i3detroit/MQTT-Thermostat/rev.1/firmware/README.md

# i3Detroit MQTT Thermostat

This is based around a d1 mini, and is designed to work with homassistant.

Can control heating and cooling, or just heating

Does not have a hold button, to prevent users from trying to heat a sieve.

## Setup
* pio
* copy local.mk.example to local.mk and edit for your wifi network
* `make flash` to progarm
