i3detroit/MQTT-Thermostat/(threads)

Thread 5 (2020-08-29):

for next rev more robust output drivers

abzman, 2020-08-29:
use proper logic families and output drivers for switching section and LED drivers

abzman, 2020-08-31:
I can cut down on chips if we agree to swap the polarity of the enable signal.  the whole select/enable circuit can be done in a single cd4000, but I'm having trouble finding them

abzman, 2020-08-31:
if we flip the output polarity (which can be done in conjunction with #3 for no functional change) then it can all be done with a 4011 or 4093 which I can source

Thread 6 (2020-08-29):

for next rev use proper LED footprints

abzman, 2020-08-29:
pick LEDs to use, including right angle ones, and use the correct footprint so the LEDs don't extend past the edge of the board (fit in the case)

Thread 8 (2020-08-29):

i3 logo

abzman, 2020-08-29:
current i3 logo is wrong, use updated logo and code

Closed 2020-08-30.

Thread 9 (2020-08-29):

eeprom reading and writing

abzman, 2020-08-29:
current method is clunky and broken, use new method retrieving data structure from memory all at once

Thread 11 (2020-08-31):

for next rev solder jumpers to select address on IO expander

abzman, 2020-08-31:
either 0603 0 ohm resistors or solder jumper pads.  Could even do a default setting with a thin trace in between pads to make it cuttable to change the address.  I realize that this isn't possible with the screen unless we move off of the daughter board, but that can be set before soldering it down.

Thread 12 (2020-08-31):

for next rev allow powering from 24vac (or 12vdc)

abzman, 2020-08-31:
Either another module or just a switcher onboard.  Make sure that if the USB is populated or you are programming it the usb's 5v either doesn't power up the whole board or if it does then the board is low power enough to be ok being powered by usb (right now relays flipping on power on cause issues unless the board is unplugged)
