i3detroit/MQTT-Thermostat/rev.2-heat/esp23 i3 heat thermostat/esp23 i3 heat thermostat.kicad_pcb

## KiCad design rev.2-heat/esp23 i3 heat thermostat/esp23 i3 heat thermostat.kicad_pcb (2022-03-13)

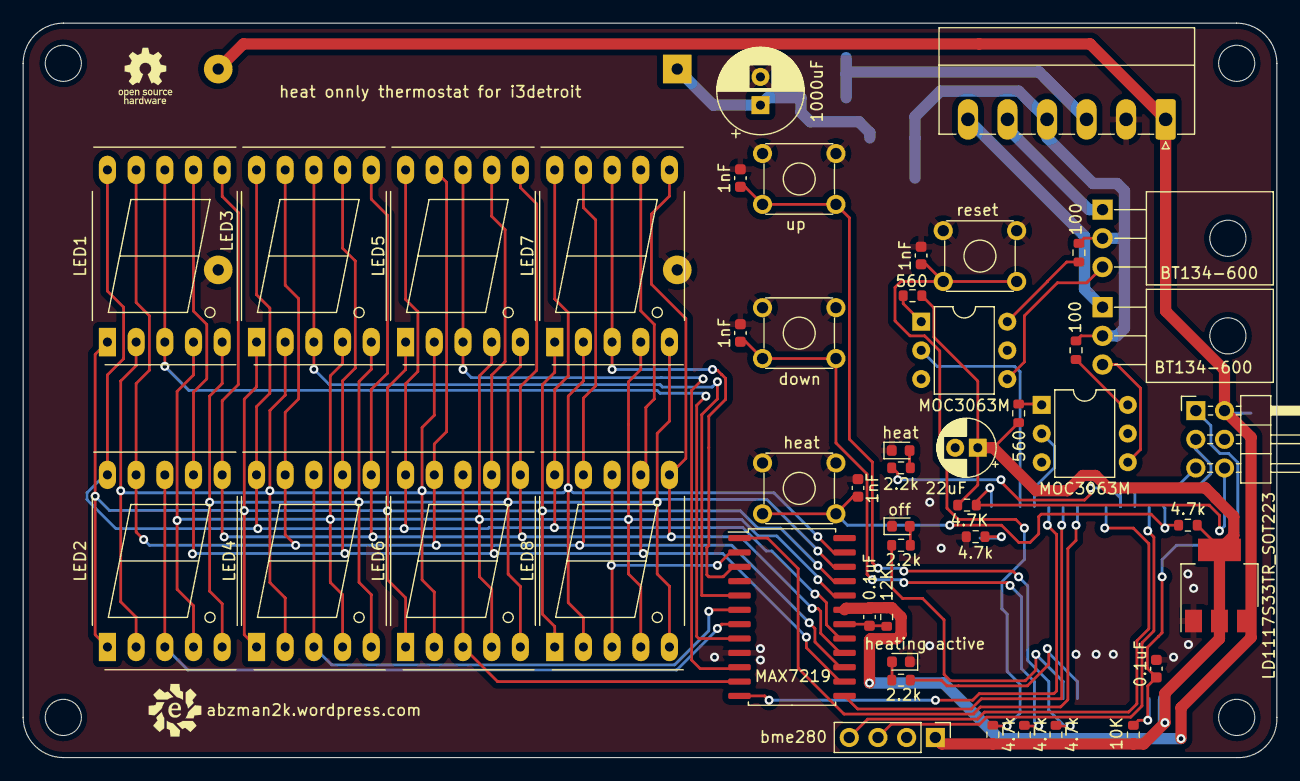
[picture p1: board esp23 i3 heat thermostat.kicad_pcb from above]

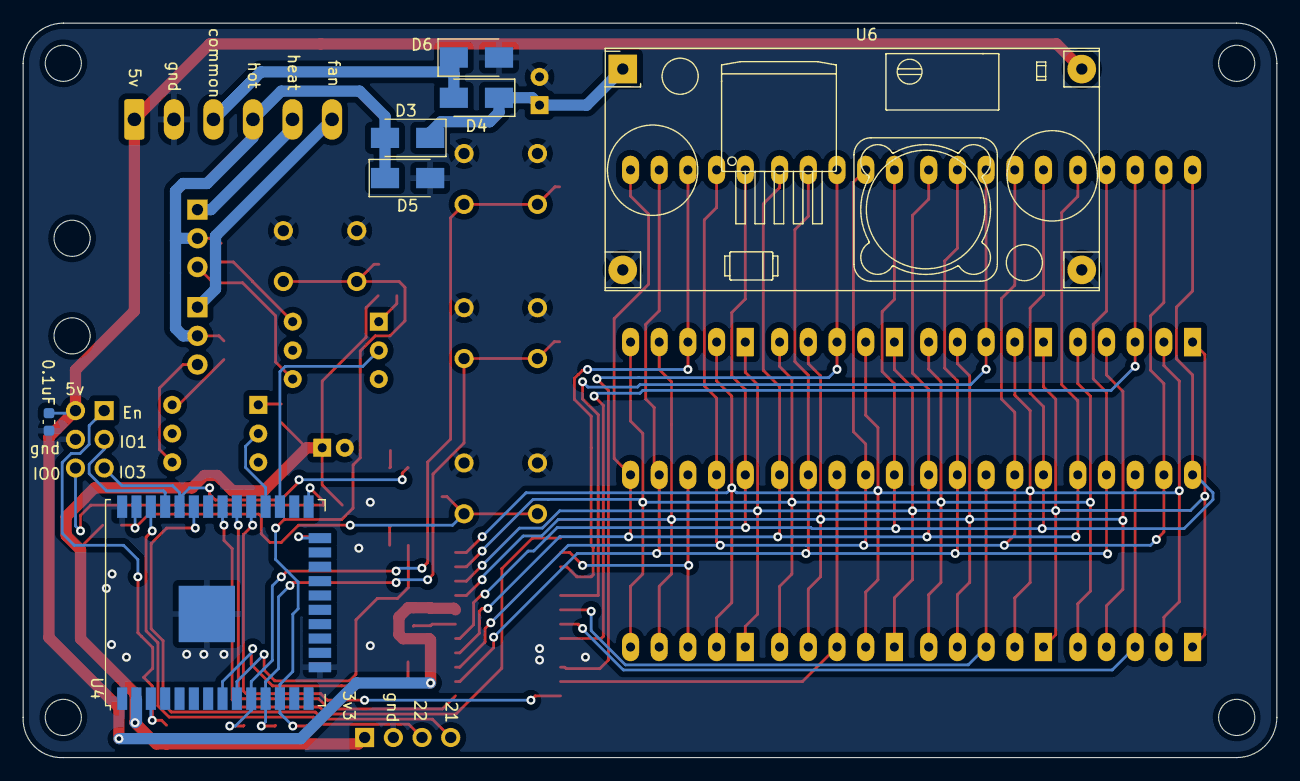
[picture p2: board esp23 i3 heat thermostat.kicad_pcb from below]

Board: 2 copper layers, 111.0 x 65.0 mm, 54 parts (7 on the bottom side), 52 nets.

Parts:
C1, C3, C7: 0.1uF; C_0603_1608Metric
C5: 1000uF; CP_Radial_D7.5mm_P2.50mm
C6: 22uF; CP_Radial_D5.0mm_P2.00mm
C8, C9, C10, C11: 1nF; C_0603_1608Metric
D3, D4, D5, D6: 1N4004; D_SMA
D8, D9, D10: LED; LED_0603_1608Metric
J1: Conn_01x06; PhoenixContact_MC_1,5_6-G-3.5_1x06_P3.50mm_Horizontal
J2: bme280; PinHeader_1x04_P2.54mm_Vertical
J4: Conn_02x03_Odd_Even; PinHeader_2x03_P2.54mm_Horizontal
LED1, LED2, LED3, LED4, LED5, LED6, LED7, LED8: LTS-6980HR; 7SegmentLED_LTS6760_LTS6780
Q1, Q2: BT134-600; TO-126-3_Horizontal_TabDown
R1: 12K; R_0603_1608Metric
R4, R5: 560; R_0603_1608Metric
R6, R7: 100; R_0603_1608Metric
R8, R15, R16, R17, R18: 4.7k; R_0603_1608Metric
R9: 10K; R_0603_1608Metric
R14: 4.7K; R_0603_1608Metric
R19, R20, R21: 2.2k; R_0603_1608Metric
SW2, SW3, SW4, SW5: SW_MEC_5E; SW_TH_Tactile_Omron_B3F-10xx
U1: MAX7219; SOP-24_7.5x15.4mm_P1.27mm
U2, U3: MOC3063M; DIP-6_W7.62mm
U4: ESP32-WROOM-32U
U5: LD1117S33TR_SOT223; SOT-223-3_TabPin2
U6: YAAJ_DCDC_StepDown_LM2596

Connections:
+3V3: C6.1, J2.1, R4.1, R5.1, R9.1, R14.1, R15.1, R16.1, R17.1, R18.1, U4.2 (VDD), U5.2 (VO)
+5V: C1.1, C7.1, J1.1, J4.2, R1.1, U1.19 (V+), U5.3 (VI), U6.4 (Vout)
+24V: C5.1, D3.1 (K), D4.1 (K), U6.1 (Vin)
/A: LED1.7 (a), LED2.7 (a), LED3.7 (a), LED4.7 (a), LED5.7 (a), LED6.7 (a), LED7.7 (a), LED8.7 (a), U1.14 (SEG_A)
/B: LED1.6 (b), LED2.6 (b), LED3.6 (b), LED4.6 (b), LED5.6 (b), LED6.6 (b), LED7.6 (b), LED8.6 (b), U1.16 (SEG_B)
/C: LED1.4 (c), LED2.4 (c), LED3.4 (c), LED4.4 (c), LED5.4 (c), LED6.4 (c), LED7.4 (c), LED8.4 (c), U1.20 (SEG_C)
/D: LED1.2 (d), LED2.2 (d), LED3.2 (d), LED4.2 (d), LED5.2 (d), LED6.2 (d), LED7.2 (d), LED8.2 (d), U1.23 (SEG_D)
/D1: LED8.3 (C.K.), LED8.8 (C.K.), U1.2 (DIG_0)
/D2: LED6.3 (C.K.), LED6.8 (C.K.), U1.11 (DIG_1)
/D3: LED4.3 (C.K.), LED4.8 (C.K.), U1.6 (DIG_2)
/D4: LED2.3 (C.K.), LED2.8 (C.K.), U1.7 (DIG_3)
/D5: LED7.3 (C.K.), LED7.8 (C.K.), U1.3 (DIG_4)
/D6: LED5.3 (C.K.), LED5.8 (C.K.), U1.10 (DIG_5)
/D7: LED3.3 (C.K.), LED3.8 (C.K.), U1.5 (DIG_6)
/D8: LED1.3 (C.K.), LED1.8 (C.K.), U1.8 (DIG_7)
/DP: LED1.5 (DP), LED2.5 (DP), LED3.5 (DP), LED4.5 (DP), LED5.5 (DP), LED6.5 (DP), LED7.5 (DP), LED8.5 (DP), U1.22 (SEG_DP)
/E: LED1.1 (e), LED2.1 (e), LED3.1 (e), LED4.1 (e), LED5.1 (e), LED6.1 (e), LED7.1 (e), LED8.1 (e), U1.21 (SEG_E)
/ESP_EN: C3.1, J4.1, R9.2, U4.3 (EN)
/ESP_IO0: J4.6, R14.2, U4.25 (IO0)
/ESP_IO1: J4.3, U4.35 (TXD0/IO1)
/ESP_IO2: R8.1, U4.24 (IO2)
/ESP_IO3: J4.5, R20.1, U4.34 (RXD0/IO3)
/ESP_IO5: U1.12 (LOAD), U4.29 (IO5)
/ESP_IO16: U2.2, U4.27 (IO16)
/ESP_IO17: U3.2, U4.28 (IO17)
/ESP_IO18: U1.13 (CLK), U4.30 (IO18)
/ESP_IO19: U1.1 (DIN), U4.31 (IO19)
/ESP_IO21: J2.4, U4.33 (IO21)
/ESP_IO22: J2.3, U4.36 (IO22)
/ESP_IO23: C11.2, R18.2, SW5.3 (K), SW5.4 (A), U4.37 (IO23)
/ESP_IO25: C10.2, R17.2, SW4.3 (K), SW4.4 (A), U4.10 (IO25)
/ESP_IO26: C9.2, R16.2, SW3.3 (K), SW3.4 (A), U4.11 (IO26)
/ESP_IO27: C8.2, R15.2, SW2.3 (K), SW2.4 (A), U4.12 (IO27)
/ESP_IO32: R19.1, U4.8 (IO32)
/ESP_IO33: R21.1, U4.9 (IO33)
/F: LED1.9 (f), LED2.9 (f), LED3.9 (f), LED4.9 (f), LED5.9 (f), LED6.9 (f), LED7.9 (f), LED8.9 (f), U1.15 (SEG_F)
/Fan: J1.6, Q2.1 (A1)
/G: LED1.10 (g), LED2.10 (g), LED3.10 (g), LED4.10 (g), LED5.10 (g), LED6.10 (g), LED7.10 (g), LED8.10 (g), U1.17 (SEG_G)
/Heat: J1.5, Q1.1 (A1)
/Hot: D3.2 (A), D5.1 (K), J1.4, Q1.2 (A2), Q2.2 (A2), R6.2, R7.2
/common: D4.2 (A), D6.1 (K), J1.3
GND: C3.2, C5.2, C6.2, C7.2, C8.1, C9.1, C10.1, C11.1, D5.2 (A), D6.2 (A), D8.1 (K), D9.1 (K), D10.1 (K), J1.2, J2.2, J4.4, R8.2, SW2.1, SW2.2, SW3.1, SW3.2, SW4.1, SW4.2, SW5.1, SW5.2, U1.4 (GND), U1.9 (GND), U4.1 (GND), U4.15 (GND), U4.38 (GND), U4.39 (GND), U5.1 (GND), U6.2 (GND), U6.3 (GND)
unnamed: C1.2, R1.2, U1.18 (ISET)
unnamed: D8.2 (A), R19.2
unnamed: D9.2 (A), R20.2
unnamed: D10.2 (A), R21.2
unnamed: Q1.3 (G), U2.4
unnamed: Q2.3 (G), U3.4
unnamed: R4.2, U2.1
unnamed: R5.2, U3.1
unnamed: R6.1, U2.6
unnamed: R7.1, U3.6
