i3detroit/MQTT-Thermostat/rev.1/board/thermostat.kicad_pcb

## KiCad design rev.1/board/thermostat.kicad_pcb (2022-02-15)

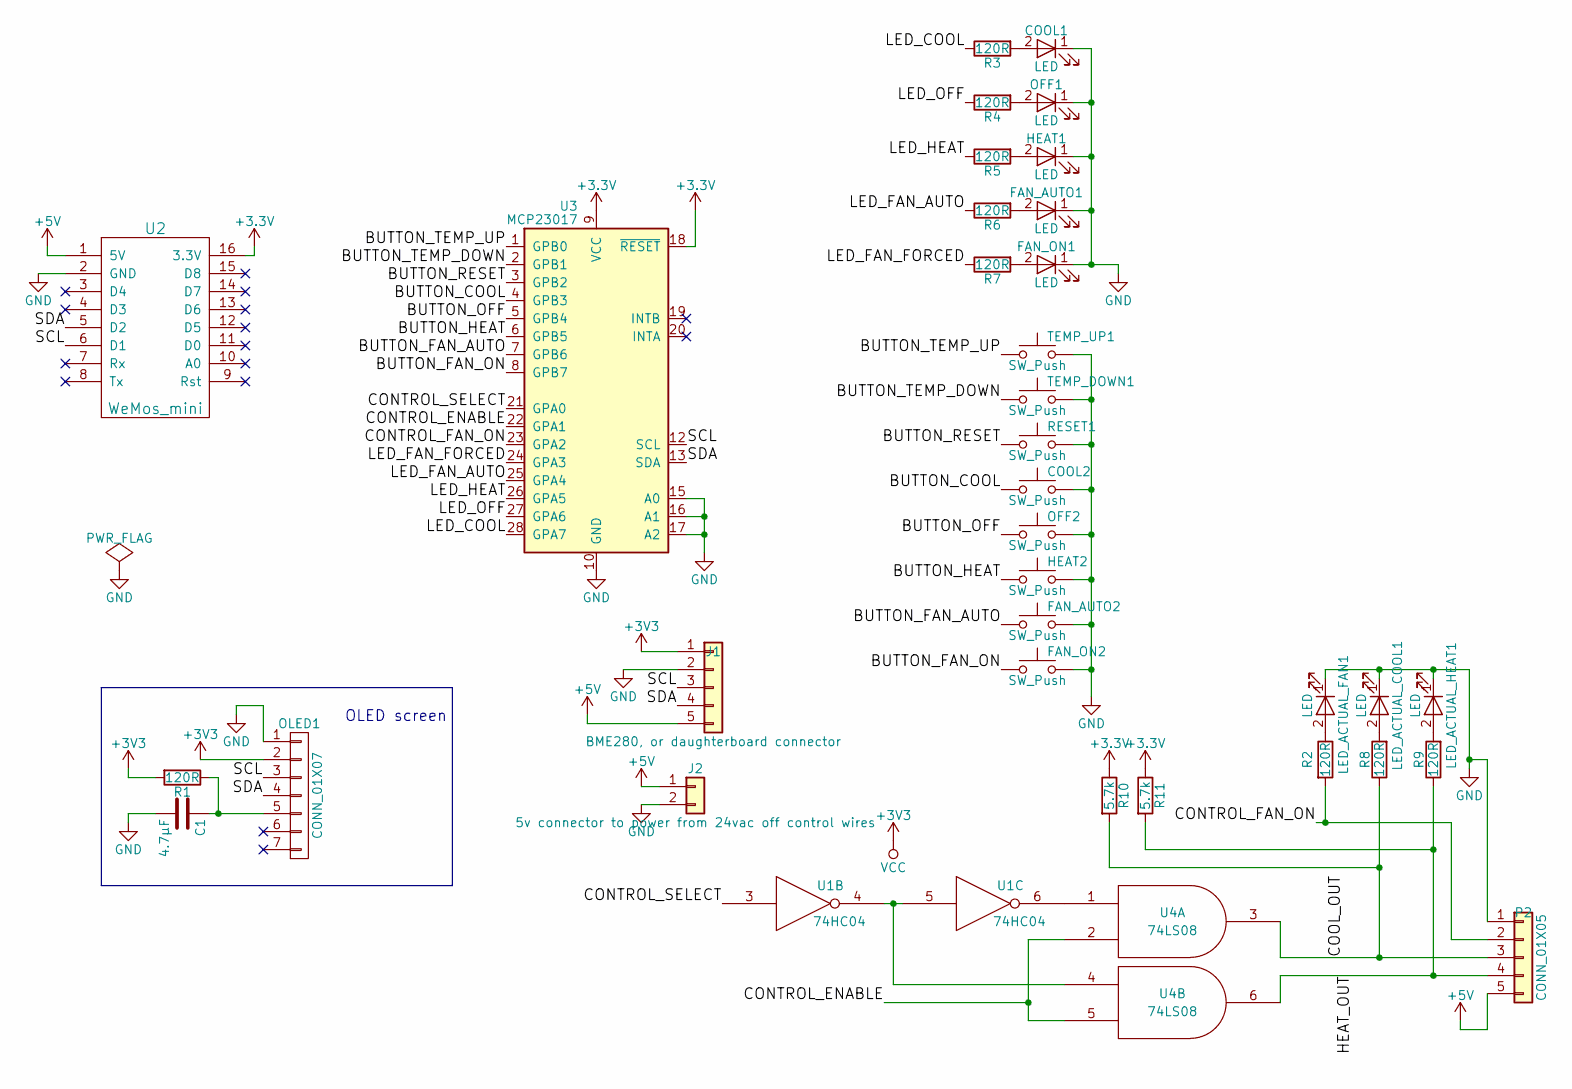
[picture p3: schematic thermostat.kicad_sch]

Parts:
C1: 4.7µF; C_0603_HandSoldering
COOL1: LED; LED_D3.0mm
COOL2: SW_Push; SW_Tactile_SPST_Angled
FAN_AUTO1: LED; LED_D3.0mm
FAN_AUTO2: SW_Push; SW_PUSH_6mm
FAN_ON1: LED; LED_D3.0mm
FAN_ON2: SW_Push; SW_PUSH_6mm
HEAT1: LED; LED_D3.0mm
HEAT2: SW_Push; SW_Tactile_SPST_Angled
J1: BME280, or daughterboard connector; Pin_Header_Straight_1x05
J2: 5v connector to power from 24vac off control wires; Pin_Header_Straight_1x02
LED_ACTUAL_COOL1: LED; LED_D3.0mm
LED_ACTUAL_FAN1: LED; LED_D3.0mm
LED_ACTUAL_HEAT1: LED; LED_D3.0mm
OFF1: LED; LED_D3.0mm
OFF2: SW_Push; SW_Tactile_SPST_Angled
OLED1: CONN_01X07; OLED_I2C_SPI
P2: CONN_01X05; Pin_Header_Straight_1x05
R1, R2, R3, R4, R5, R6, R7, R8, R9: 120R; R_0603_HandSoldering
R10, R11: 5.7k; R_0603_HandSoldering
RESET1: SW_Push; SW_PUSH_6mm
TEMP_DOWN1: SW_Push; SW_PUSH_6mm
TEMP_UP1: SW_Push; SW_PUSH_6mm
U1: 74HC04; DIP-14_W7.62mm
U2: WeMos_mini; D1_mini_board
U3: MCP23017; DIP-28_W7.62mm
U4: 74LS08; DIP-14_W7.62mm_cuttable-trace

Connections:
+5V: J1.5, J2.1, P2.5, U2.1 (5V)
/BUTTON_COOL: COOL2.1, U3.4 (GPB3)
/BUTTON_FAN_AUTO: FAN_AUTO2.1, U3.7 (GPB6)
/BUTTON_FAN_ON: FAN_ON2.1, U3.8 (GPB7)
/BUTTON_HEAT: HEAT2.1, U3.6 (GPB5)
/BUTTON_OFF: OFF2.1, U3.5 (GPB4)
/BUTTON_RESET: RESET1.1, U3.3 (GPB2)
/BUTTON_TEMP_DOWN: TEMP_DOWN1.1, U3.2 (GPB1)
/BUTTON_TEMP_UP: TEMP_UP1.1, U3.1 (GPB0)
/CONTROL_ENABLE: U3.22 (GPA1), U4.2, U4.5
/CONTROL_FAN_ON: P2.2, R2.2, U3.23 (GPA2)
/CONTROL_SELECT: U1.3, U3.21 (GPA0)
/COOL_OUT: P2.3, R8.1, R10.2, U4.3
/HEAT_OUT: P2.4, R9.1, R11.2, U4.6
/LED_COOL: R3.1, U3.28 (GPA7)
/LED_FAN_AUTO: R6.1, U3.25 (GPA4)
/LED_FAN_FORCED: R7.1, U3.24 (GPA3)
/LED_HEAT: R5.1, U3.26 (GPA5)
/LED_OFF: R4.1, U3.27 (GPA6)
/SCL: J1.3, OLED1.3, U2.6 (D1), U3.12 (SCL)
/SDA: J1.4, OLED1.4, U2.5 (D2), U3.13 (SDA)
GND: C1.2, COOL1.1 (K), COOL2.2, FAN_AUTO1.1 (K), FAN_AUTO2.2, FAN_ON1.1 (K), FAN_ON2.2, HEAT1.1 (K), HEAT2.2, J1.2, J2.2, LED_ACTUAL_COOL1.1 (K), LED_ACTUAL_FAN1.1 (K), LED_ACTUAL_HEAT1.1 (K), OFF1.1 (K), OFF2.2, OLED1.1, P2.1, RESET1.2, TEMP_DOWN1.2, TEMP_UP1.2, U1.7 (GND), U2.2 (GND), U3.10 (GND), U3.15 (A0), U3.16 (A1), U3.17 (A2), U4.7 (GND)
unnamed: C1.1, OLED1.5, R1.1
unnamed: COOL1.2 (A), R3.2
unnamed: FAN_AUTO1.2 (A), R6.2
unnamed: FAN_ON1.2 (A), R7.2
unnamed: HEAT1.2 (A), R5.2
unnamed: LED_ACTUAL_COOL1.2 (A), R8.2
unnamed: LED_ACTUAL_FAN1.2 (A), R2.1
unnamed: LED_ACTUAL_HEAT1.2 (A), R9.2
unnamed: OFF1.2 (A), R4.2
unnamed: U1.4, U1.5, U4.4
unnamed: U1.6, U4.1

Notes on the sheet:
OLED screen

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
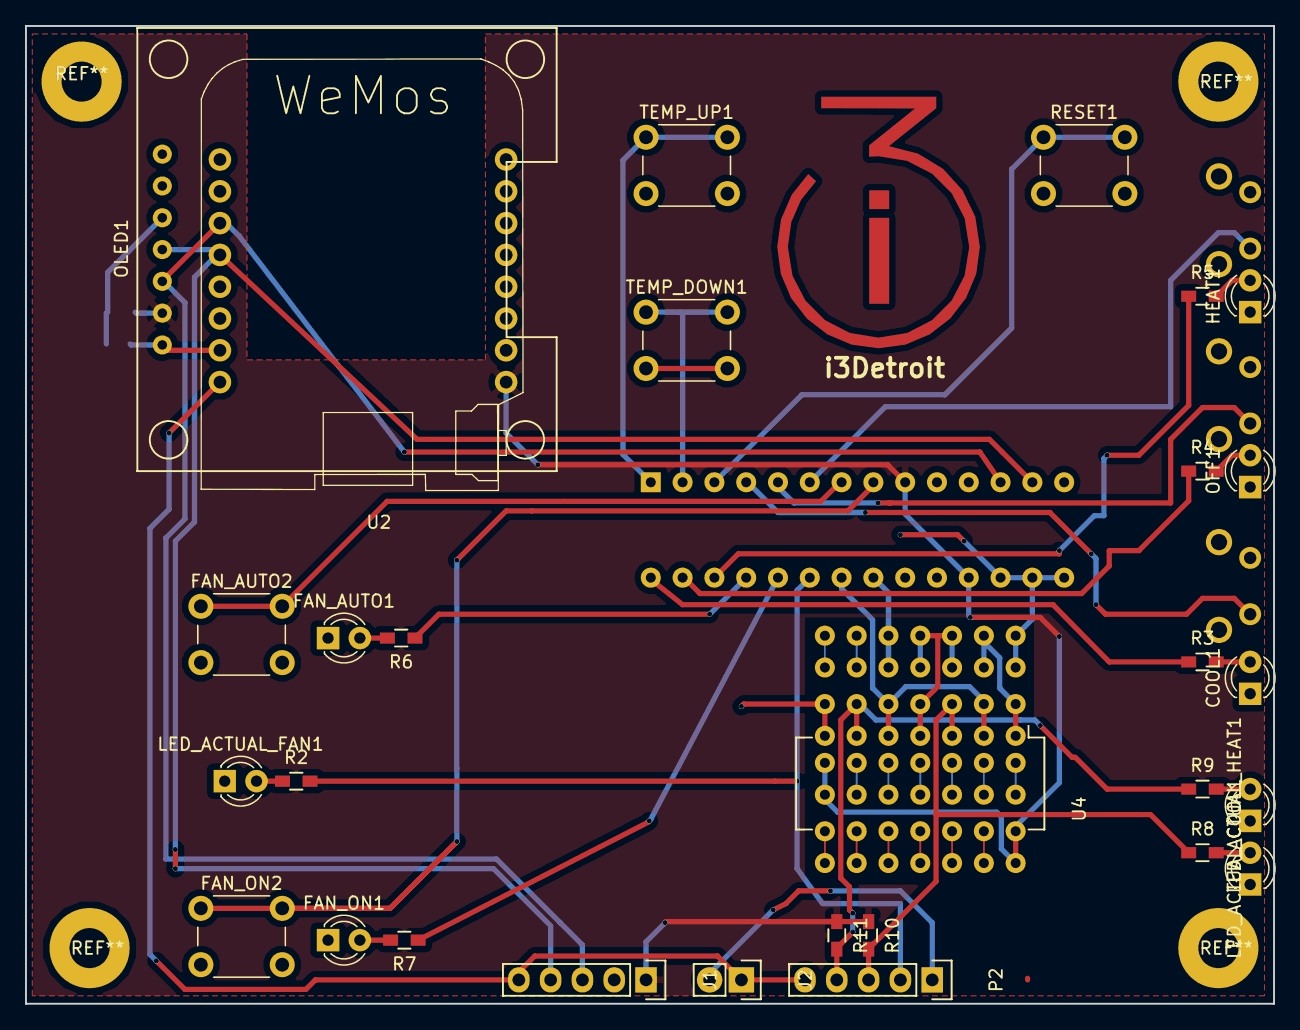
[picture p4: board thermostat.kicad_pcb from above]

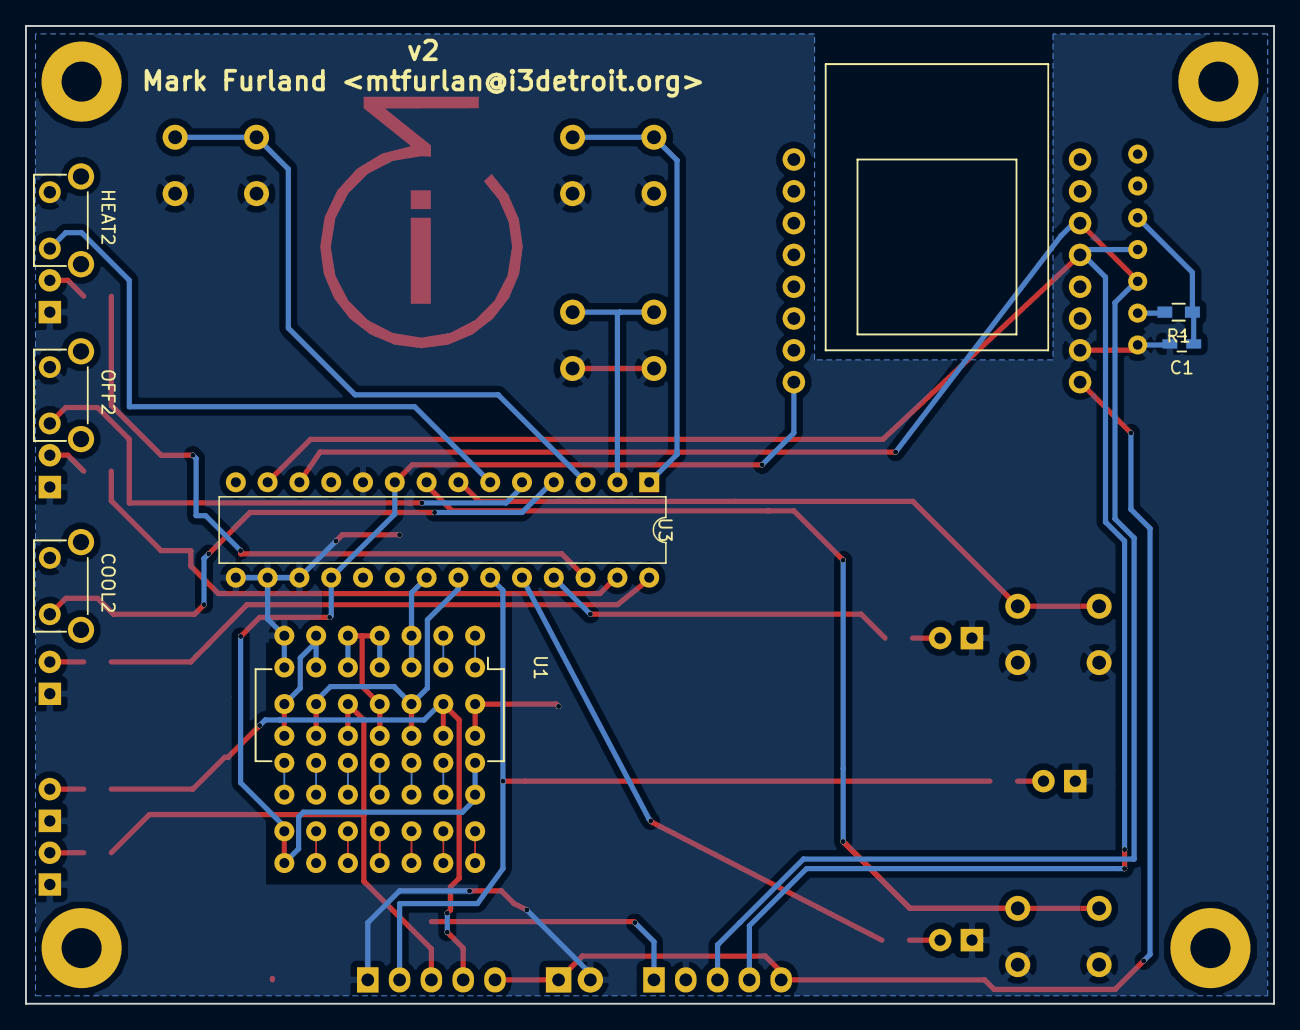
[picture p5: board thermostat.kicad_pcb from below]

Board: 2 copper layers, 99.7 x 78.1 mm, 37 parts (7 on the bottom side), 34 nets.

Other parts of the board:
svg2mod: G***; i3Logo
