i3detroit/MQTT-Thermostat/rev.1/firmware/src/pins.h

#define MAINS_TEST_PIN 13 //D7

#define FAN_CONTROL 5 //force on fan, 0 is on. If 1, is auto, furnace will tunr on fan
#define ENABLE_CONTROL 6 //enable/disable heat/cool
#define SELECT_CONTROL 7 //heat:0 cool: 1

#define BTN_RESET 2

#define BTN_FAN_ON 7
#define BTN_FAN_AUTO 6
#define LED_FAN_ON 4
#define LED_FAN_AUTO 3

#define TEMP_UP 0
#define TEMP_DOWN 1

#define BTN_HEAT 5
#define LED_HEAT 2

#define BTN_OFF 4
#define LED_OFF 1

#define BTN_COOL 3
#define LED_COOL 0
