i3detroit/MQTT-Thermostat/rev.1/firmware/src/i3Logo.h

#define i3Logo_width 64
#define i3Logo_height 64
static const unsigned char i3Logo_bits[] U8X8_PROGMEM = {
   0x00, 0x00, 0x00, 0x00, 0x00, 0x00, 0x00, 0x00, 0x00, 0x00, 0x00, 0x00,
   0x00, 0x00, 0x00, 0x00, 0x00, 0x00, 0xfc, 0xff, 0xff, 0x3f, 0x00, 0x00,
   0x00, 0x00, 0xfc, 0xff, 0xff, 0x3f, 0x00, 0x00, 0x00, 0x00, 0xfc, 0xff,
   0xff, 0x3f, 0x00, 0x00, 0x00, 0x00, 0x00, 0x00, 0x00, 0x1f, 0x00, 0x00,
   0x00, 0x00, 0x00, 0x00, 0x80, 0x0f, 0x00, 0x00, 0x00, 0x00, 0x00, 0x00,
   0xe0, 0x03, 0x00, 0x00, 0x00, 0x00, 0x00, 0x00, 0xf0, 0x01, 0x00, 0x00,
   0x00, 0x00, 0x00, 0x00, 0xf8, 0x00, 0x00, 0x00, 0x00, 0x00, 0x00, 0x00,
   0x7c, 0x00, 0x00, 0x00, 0x00, 0x00, 0x00, 0x00, 0x1f, 0x00, 0x00, 0x00,
   0x00, 0x00, 0x00, 0x80, 0x0f, 0x00, 0x00, 0x00, 0x00, 0x00, 0x00, 0xc0,
   0x07, 0x00, 0x00, 0x00, 0x00, 0x00, 0x00, 0xc0, 0x3f, 0x00, 0x00, 0x00,
   0x00, 0x00, 0x00, 0xc0, 0xff, 0x01, 0x00, 0x00, 0x00, 0x00, 0x00, 0x00,
   0xf8, 0x07, 0x00, 0x00, 0x00, 0x00, 0x00, 0x00, 0x80, 0x1f, 0x00, 0x00,
   0x00, 0x00, 0x00, 0x00, 0x00, 0x3c, 0x00, 0x00, 0x00, 0x00, 0x00, 0x00,
   0x00, 0xf8, 0x00, 0x00, 0x00, 0x00, 0x00, 0x00, 0x00, 0xe0, 0x01, 0x00,
   0x00, 0xc0, 0x00, 0x00, 0x00, 0xc0, 0x03, 0x00, 0x00, 0xe0, 0x01, 0x00,
   0x00, 0x80, 0x07, 0x00, 0x00, 0xe0, 0x00, 0x00, 0x00, 0x00, 0x07, 0x00,
   0x00, 0x70, 0x00, 0xc0, 0x03, 0x00, 0x0e, 0x00, 0x00, 0x38, 0x00, 0xc0,
   0x07, 0x00, 0x1c, 0x00, 0x00, 0x38, 0x00, 0xc0, 0x07, 0x00, 0x1c, 0x00,
   0x00, 0x1c, 0x00, 0xc0, 0x07, 0x00, 0x38, 0x00, 0x00, 0x1c, 0x00, 0xc0,
   0x03, 0x00, 0x38, 0x00, 0x00, 0x0e, 0x00, 0x00, 0x00, 0x00, 0x70, 0x00,
   0x00, 0x0e, 0x00, 0x00, 0x00, 0x00, 0x70, 0x00, 0x00, 0x06, 0x00, 0xc0,
   0x07, 0x00, 0x60, 0x00, 0x00, 0x07, 0x00, 0xc0, 0x07, 0x00, 0xe0, 0x00,
   0x00, 0x07, 0x00, 0xc0, 0x07, 0x00, 0xe0, 0x00, 0x00, 0x07, 0x00, 0xc0,
   0x07, 0x00, 0xe0, 0x00, 0x00, 0x07, 0x00, 0xc0, 0x07, 0x00, 0xe0, 0x00,
   0x00, 0x03, 0x00, 0xc0, 0x07, 0x00, 0xc0, 0x00, 0x00, 0x03, 0x00, 0xc0,
   0x07, 0x00, 0xc0, 0x00, 0x00, 0x03, 0x00, 0xc0, 0x07, 0x00, 0xc0, 0x00,
   0x00, 0x03, 0x00, 0xc0, 0x07, 0x00, 0xc0, 0x00, 0x00, 0x07, 0x00, 0xc0,
   0x07, 0x00, 0xe0, 0x00, 0x00, 0x07, 0x00, 0xc0, 0x07, 0x00, 0xe0, 0x00,
   0x00, 0x07, 0x00, 0xc0, 0x07, 0x00, 0xe0, 0x00, 0x00, 0x06, 0x00, 0xc0,
   0x07, 0x00, 0x60, 0x00, 0x00, 0x06, 0x00, 0xc0, 0x07, 0x00, 0x60, 0x00,
   0x00, 0x0e, 0x00, 0xc0, 0x07, 0x00, 0x70, 0x00, 0x00, 0x0e, 0x00, 0xc0,
   0x07, 0x00, 0x70, 0x00, 0x00, 0x1c, 0x00, 0xc0, 0x07, 0x00, 0x38, 0x00,
   0x00, 0x1c, 0x00, 0xc0, 0x07, 0x00, 0x38, 0x00, 0x00, 0x38, 0x00, 0xc0,
   0x07, 0x00, 0x1c, 0x00, 0x00, 0x78, 0x00, 0xc0, 0x07, 0x00, 0x1e, 0x00,
   0x00, 0x70, 0x00, 0x00, 0x00, 0x00, 0x0e, 0x00, 0x00, 0xe0, 0x00, 0x00,
   0x00, 0x00, 0x07, 0x00, 0x00, 0xc0, 0x01, 0x00, 0x00, 0x80, 0x03, 0x00,
   0x00, 0x80, 0x03, 0x00, 0x00, 0xc0, 0x01, 0x00, 0x00, 0x00, 0x0f, 0x00,
   0x00, 0xf0, 0x00, 0x00, 0x00, 0x00, 0x1e, 0x00, 0x00, 0x78, 0x00, 0x00,
   0x00, 0x00, 0x7c, 0x00, 0x00, 0x3e, 0x00, 0x00, 0x00, 0x00, 0xf0, 0x03,
   0xc0, 0x0f, 0x00, 0x00, 0x00, 0x00, 0xe0, 0xff, 0xff, 0x07, 0x00, 0x00,
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
