i3detroit/MQTT-Thermostat/(commit log)

2020-02-15 feat: move to it's own repo
    [thermostat.kicad_pcb, thermostat.sch]
2020-08-30 Make tests less intrusive but also broken
    [doControl.cpp, doControl.h, thermostat.h, thermostat.ino]
2020-08-30 fix(i3 logo): Magic fix from abzman
    Closes #8
    [i3Logo.h]
2022-02-15 moved files and added second rev thermostat schematic
    [Indicator LED.kicad_sch, esp23 i3 heat thermostat.kicad_pcb, esp23 i3 heat thermostat.kicad_sch, filtered_button.kicad_sch, thermostat-2022-01-06-13-59-49.sch, thermostat.kicad_pcb, thermostat.kicad_sch, thermostat.sch]
2022-02-15 initial layout for UX
    [Indicator LED.kicad_sch, esp23 i3 heat thermostat.kicad_pcb, esp23 i3 heat thermostat.kicad_sch, filtered_button.kicad_sch]
2022-02-19 layout attempt 1
    [Indicator LED.kicad_sch, esp23 i3 heat thermostat.kicad_pcb, esp23 i3 heat thermostat.kicad_sch, filtered_button.kicad_sch]
2022-02-19 added mounting holes
    [esp23 i3 heat thermostat.kicad_pcb]
2022-02-19 add fourth corner hole
    [esp23 i3 heat thermostat.kicad_pcb]
2022-03-13 generated gerbers
    [esp23 i3 heat thermostat-B_Cu.gbl, esp23 i3 heat thermostat-B_Mask.gbs, esp23 i3 heat thermostat-B_Paste.gbp, esp23 i3 heat thermostat-B_Silkscreen.gbo, esp23 i3 heat thermostat-Edge_Cuts.gm1, esp23 i3 heat thermostat-F_Cu.gtl, esp23 i3 heat thermostat-F_Mask.gts, esp23 i3 heat thermostat-F_Paste.gtp]
2022-04-01 added test code in arduino to validate some hardware
